bingran/iSEB-Crab/Release/202309/iSEB_Spider_202309.pdf

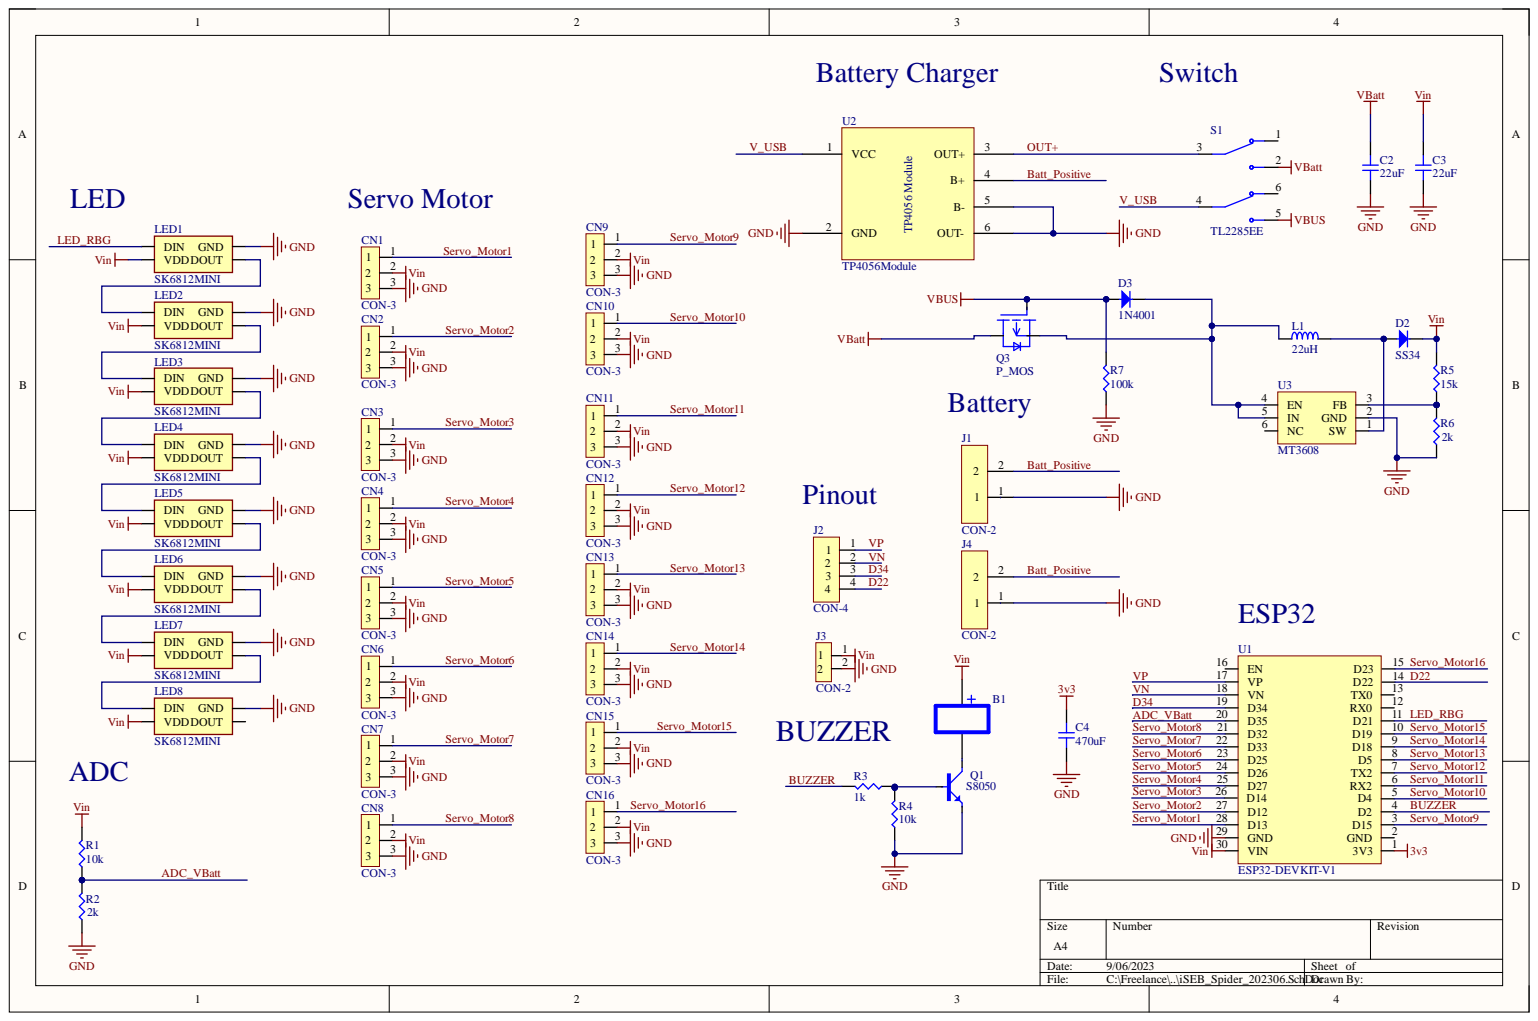
[picture p65: page 1]
