bingran/iSEB-Crab/(commit log)

2023-09-13 Update of index name and change button colour during onclick
2024-07-21 Update ledc setup to adapt 3.X.X esp32 library
